haxko/haxko-smd-led-kit/CHANGELOG.md

# haxko - SMD LED practice kit - Changelog

## Rev 1
* Erster Prototyp
## Rev 2
* Poti gegen festen Resistor entfernt, Timing-Einstellung hatte ohnehin nicht sauber funktioniert
* Befestigungslöcher symmetrisch gestaltet
* Lötfläche für Sicherheitsnadel hinzugefügt
* Texte sauber gestaltet
## Rev 3 (WIP)
* Größere Pads für LED und Transistoren
* Überflüssiger Widerstand entfernt
* Platz für alternativen Batteriehalter
* QR-Code zur Anleitung
* Logos in korrekter Font
