haxko/haxko-smd-led-kit/(commit log)

2019-11-24 Schematic-Backups ignorieren
2019-11-24 README: Hinweis zu Software und Videos
2019-11-24 Bestellnummern LCSC
    [haxko-badge.sch]
2019-11-24 Erster Entwurf Rev3
    [haxko-badge.kicad_pcb, haxko-badge.sch]
2021-12-28 Gerüchte besagen korrekte Polarität der Batterie würde die Funktion positiv beeinflussen
    [haxko-badge.kicad_pcb]
2021-12-28 Größere Pads für Transistoren
    [haxko-badge.kicad_pcb, haxko-badge.sch]
2021-12-28 Dickere Traces - sollten gröbere Lötversuche eher überstehen
    [haxko-badge.kicad_pcb]
2021-12-28 Aktuelle 3D-Modell-Pfade hinterlegt (front only)
    [haxko-badge.kicad_pcb]
2023-02-20 Bump to KiCAD 6 format
    [haxko-badge.kicad_pcb, haxko-badge.kicad_sch, haxko-badge.sch]
2023-09-22 bump KiCAD 7
    [haxko-badge.kicad_pcb, haxko-badge.kicad_sch]
2023-09-22 Hide designators
    [haxko-badge.kicad_pcb]
2023-10-10 Change Text to Mayen-Koblenz
    [haxko-badge.kicad_pcb]
2023-10-10 LEDs: Larger pads, markings below diode
    [haxko-badge.kicad_pcb]
2023-10-14 Anleitung: Schematic Update (sort of)
