haxko/haxko-smd-led-kit/(notices)

Notices in the files:
README.md:
http://creativecommons.org/licenses/by-sa/4.0
